karol-gruszczyk/arduino-racing-unit/README.md

# Racing Unit
Launch Control, Wheelie Control, QuickShifter
