karol-gruszczyk/arduino-racing-unit/schematic.pdf

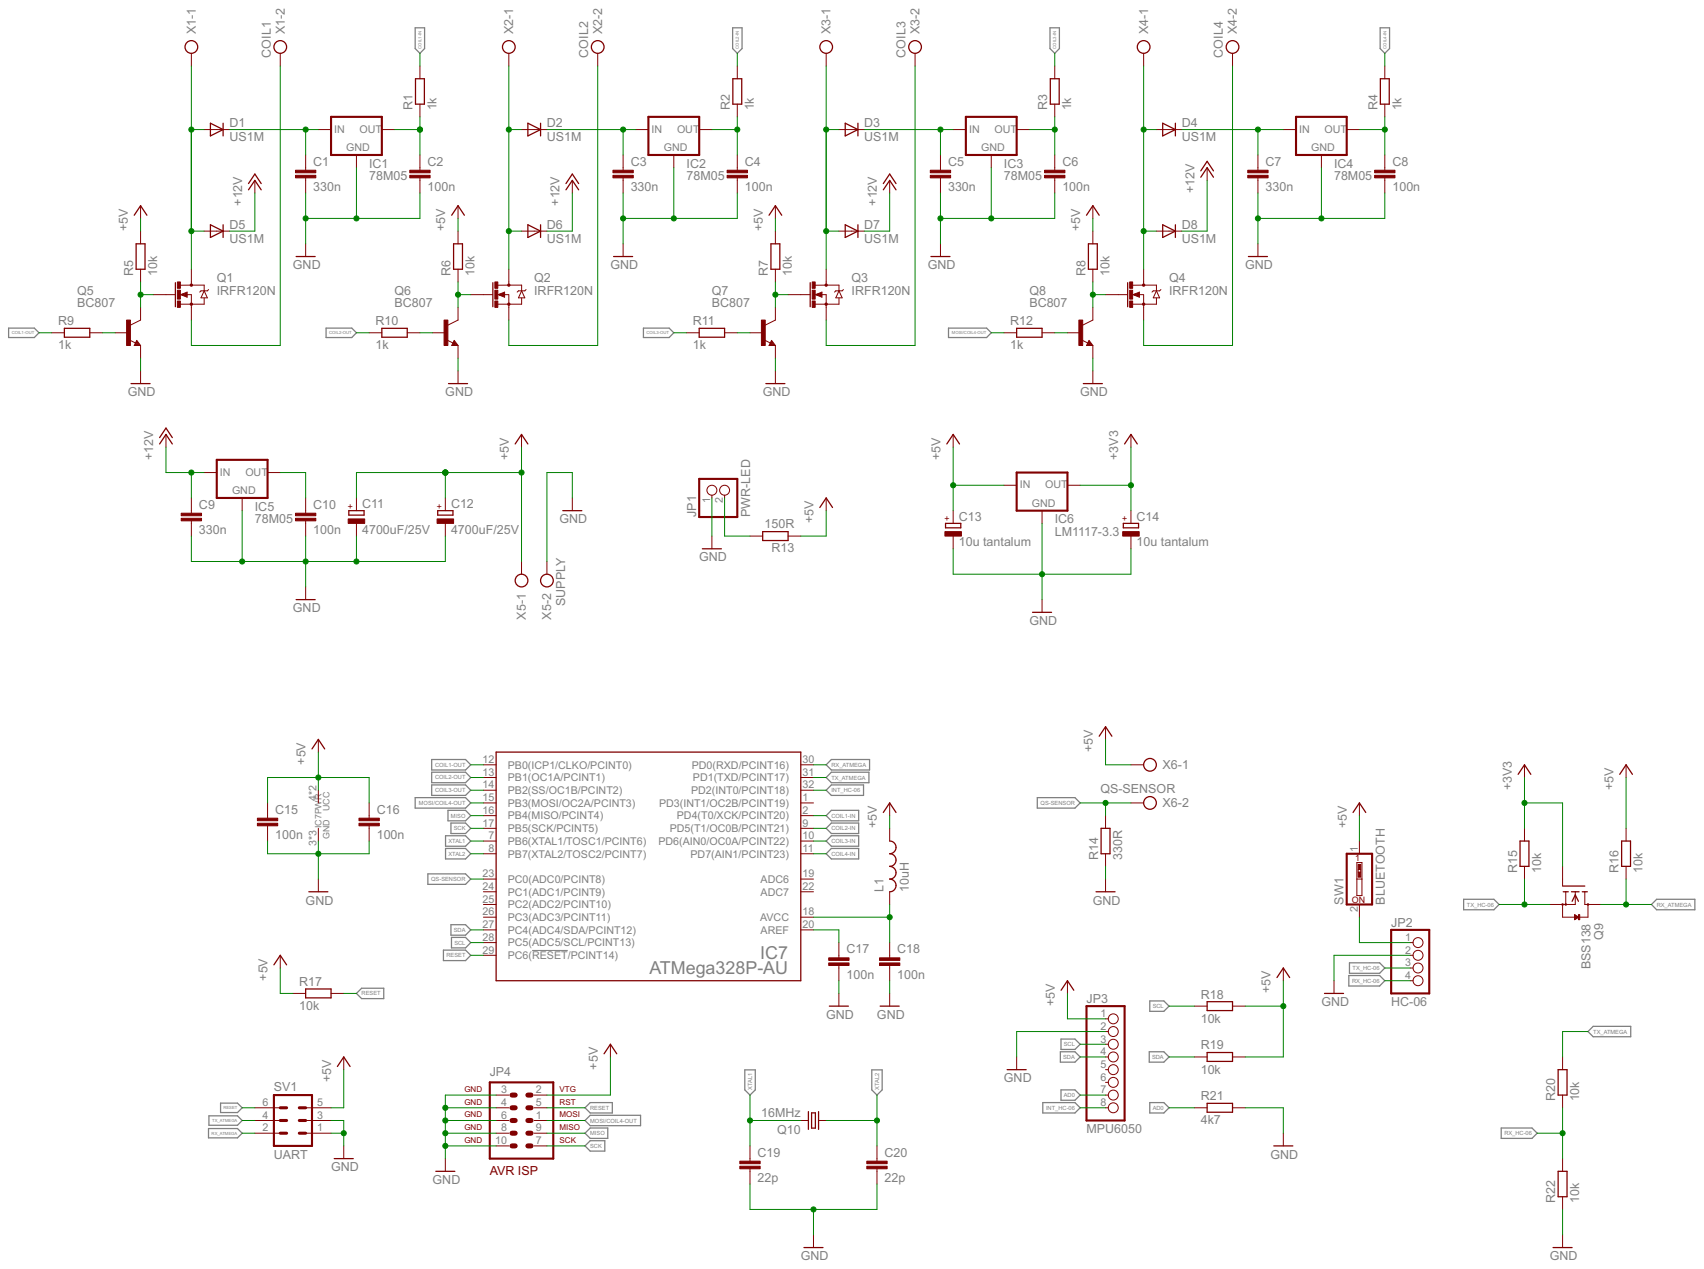
[picture p1: page 1]
