karol-gruszczyk/arduino-racing-unit/racing_unit.sch

## EAGLE design racing_unit.sch (2017-01-27)

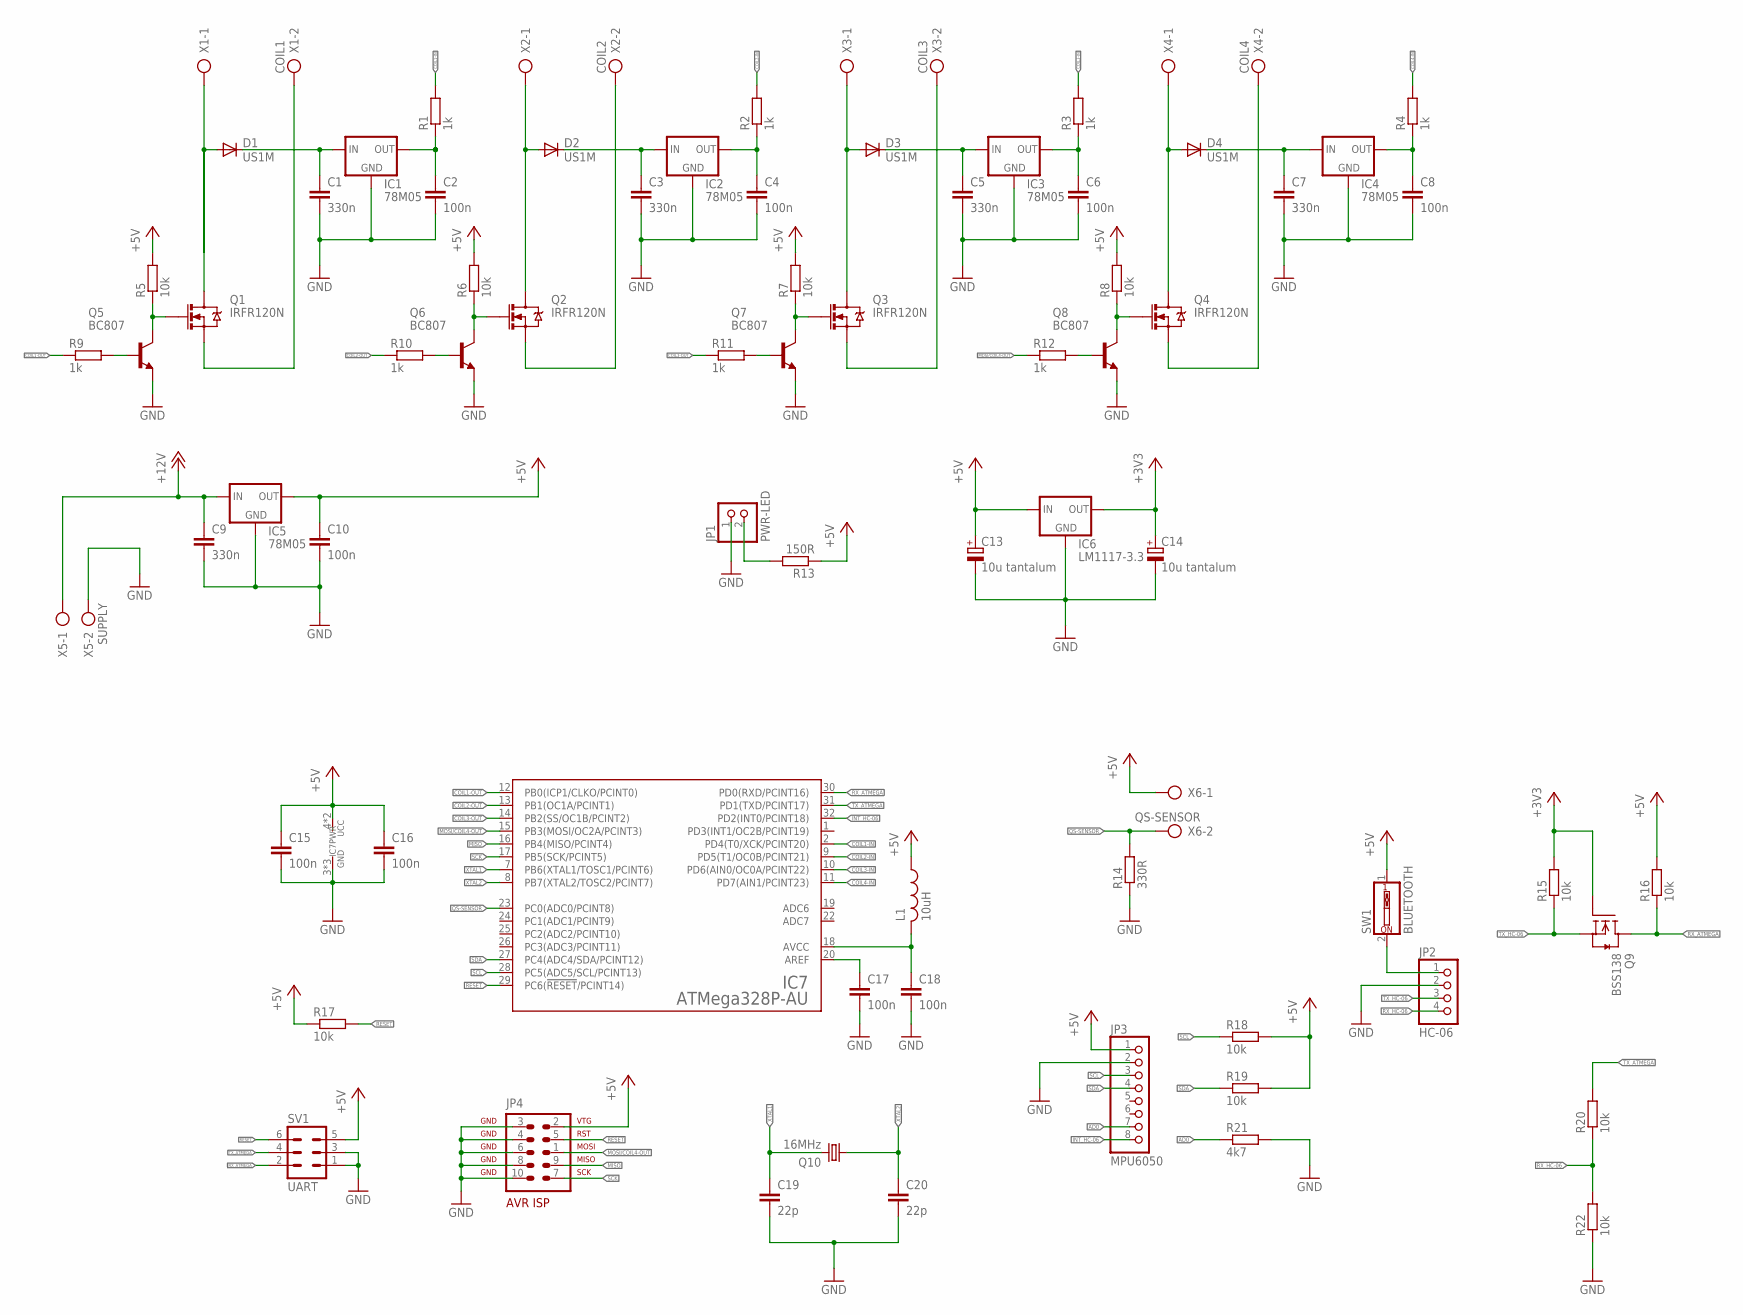
[picture p2: schematic racing_unit.sch]

Parts:
C1, C3, C5, C7, C9: 330n; C0805
C2, C4, C6, C8, C10, C15, C16, C17, C18: 100n; C0805
C13, C14: 10u tantalum; A/3216-18R
C19, C20: 22p; C0805
D1, D2, D3, D4: US1M; DO214AC
IC1, IC2, IC3, IC4, IC5: 78M05; TO252
IC6: LM1117-3.3; SOT223
IC7: ATMega328P-AU; TQFP32-08
JP1: PWR-LED; 1X02
JP2: HC-06; 1X04
JP3: MPU6050; 1X08
JP4: AVR-ISP-10ML; ML10
L1: 10uH; 0207/10
Q1, Q2, Q3, Q4: IRFR120N; D-PAK_TO252AA
Q5, Q6, Q7, Q8: BC807; SOT23-BEC
Q9: BSS138; SOT23
Q10: 16MHz; HC49/S
R1, R2, R3, R4, R9, R10, R11, R12: 1k; M0805
R5, R6, R7, R8, R15, R16, R17, R18, R19, R20, R22: 10k; M0805
R13: 150R; 0204/5
R14: 330R; 0204/5
R21: 4k7; M0805
SV1: UART; ML6
SW1: BLUETOOTH; EDG-01
X1: COIL1; AK500/2
X2: COIL2; AK500/2
X3: COIL3; AK500/2
X4: COIL4; AK500/2
X5: SUPPLY; AK500/2
X6: QS-SENSOR; AK500/2

Connections:
+3V3: C14.+, IC6.2 (OUT), Q9.1 (G), R15.2
+5V: C10.1, C13.+, C15.1, C16.1, IC5.3 (OUT), IC6.3 (IN), IC7.4 (UCC), JP3.1, JP4.2, L1.1, R5.2, R6.2, R7.2, R8.2, R13.1, R16.2, R17.1, R18.2, R19.2, SV1.5, SW1.1, X6.1
+12V: C9.1, IC5.2 (IN), X5.1
AD0: JP3.7, R21.1
COIL1-IN: IC7.2 (PD4(T0/XCK/PCINT20)), R1.2
COIL1-OUT: IC7.12 (PB0(ICP1/CLKO/PCINT0)), R9.1
COIL2-IN: IC7.9 (PD5(T1/OC0B/PCINT21)), R2.2
COIL2-OUT: IC7.13 (PB1(OC1A/PCINT1)), R10.1
COIL3-IN: IC7.10 (PD6(AIN0/OC0A/PCINT22)), R3.2
COIL3-OUT: IC7.14 (PB2(SS/OC1B/PCINT2)), R11.1
COIL4-IN: IC7.11 (PD7(AIN1/PCINT23)), R4.2
GND: C1.2, C2.2, C3.2, C4.2, C5.2, C6.2, C7.2, C8.2, C9.2, C10.2, C13.-, C14.-, C15.2, C16.2, C17.2, C18.2, C19.2, C20.2, IC1.1 (GND), IC2.1 (GND), IC3.1 (GND), IC4.1 (GND), IC5.1 (GND), IC6.1 (GND), IC7.3 (GND), JP1.1, JP2.2, JP3.2, JP4.3, JP4.4, JP4.6, JP4.8, JP4.10, Q5.E, Q6.E, Q7.E, Q8.E, R14.1, R21.2, R22.1, SV1.1, SV1.3, X5.2
INT_HC-06: IC7.32 (PD2(INT0/PCINT18)), JP3.8
MISO: IC7.16 (PB4(MISO/PCINT4)), JP4.9
MOSI/COIL4-OUT: IC7.15 (PB3(MOSI/OC2A/PCINT3)), JP4.1, R12.1
unnamed: D1.A, Q1.2 (D), X1.1
unnamed: D2.A, Q2.2 (D), X2.1
unnamed: D3.A, Q3.2 (D), X3.1
unnamed: D4.A, Q4.2 (D), X4.1
unnamed: C17.1, IC7.20 (AREF)
unnamed: C18.1, IC7.18 (AVCC), L1.2
unnamed: Q5.B, R9.2
unnamed: Q6.B, R10.2
unnamed: Q4.3 (S), X4.2
unnamed: Q3.3 (S), X3.2
unnamed: Q2.3 (S), X2.2
unnamed: Q1.3 (S), X1.2
unnamed: JP1.2, R13.2
unnamed: C2.1, IC1.3 (OUT), R1.1
unnamed: C4.1, IC2.3 (OUT), R2.1
unnamed: Q7.B, R11.2
unnamed: C8.1, IC4.3 (OUT), R4.1
unnamed: C6.1, IC3.3 (OUT), R3.1
unnamed: Q8.B, R12.2
unnamed: JP2.1, SW1.2
unnamed: C1.1, D1.C, IC1.2 (IN)
unnamed: C3.1, D2.C, IC2.2 (IN)
unnamed: C5.1, D3.C, IC3.2 (IN)
unnamed: C7.1, D4.C, IC4.2 (IN)
unnamed: Q1.1 (G), Q5.C, R5.1
unnamed: Q2.1 (G), Q6.C, R6.1
unnamed: Q3.1 (G), Q7.C, R7.1
unnamed: Q4.1 (G), Q8.C, R8.1
QS-SENSOR: IC7.23 (PC0(ADC0/PCINT8)), R14.2, X6.2
RESET: IC7.29 (PC6(!RESET!/PCINT14)), JP4.5, R17.2, SV1.6
RX_ATMEGA: IC7.30 (PD0(RXD/PCINT16)), Q9.3 (D), R16.1, SV1.2
RX_HC-06: JP2.4, R20.1, R22.2
SCK: IC7.17 (PB5(SCK/PCINT5)), JP4.7
SCL: IC7.28 (PC5(ADC5/SCL/PCINT13)), JP3.3, R18.1
SDA: IC7.27 (PC4(ADC4/SDA/PCINT12)), JP3.4, R19.1
TX_ATMEGA: IC7.31 (PD1(TXD/PCINT17)), R20.2, SV1.4
TX_HC-06: JP2.3, Q9.2 (S), R15.1
XTAL1: C19.1, IC7.7 (PB6(XTAL1/TOSC1/PCINT6)), Q10.2
XTAL2: C20.1, IC7.8 (PB7(XTAL2/TOSC2/PCINT7)), Q10.1
