karol-gruszczyk/arduino-racing-unit/racing_unit/setup_defaults/defaults.h

#define BLUETOOTH_NAME "Racing Unit"
#define BLUETOOTH_PIN "1234"
#define BLUETOOTH_BAUD_RATE "8"  // 115200
#define BLUETOOTH_BAUD_RATE_VERBOSE "115200"

#define CYLINDER_NUMBER 4

#define DEFAULT_LAUNCH_CONTROL_RPM 6000
#define DEFAULT_LAUNCH_CONTROL_KILL_TIME 100
#define DEFAULT_LAUNCH_CONTROL_WORKING_TIME 2000

#define DEFAULT_WHEELIE_CONTROL_ENABLED false
#define DEFAULT_WHEELIE_CONTROL_MAX_ANGLE 10
#define DEFAULT_WHEELIE_CONTROL_KILL_TIME 100

#define DEFAULT_QUICK_SHIFTER_ENABLED false
#define DEFAULT_QUICK_SHIFTER_MIN_RPM 2500
#define DEFAULT_QUICK_SHIFTER_MAX_RPM 14000
#define DEFAULT_QUICK_SHIFTER_SENSITIVITY 10
#define DEFAULT_QUICK_SHIFTER_KILL_TIME_AT_RPM {{2500, 80}, {4000, 80}, {5500, 75}, {7000, 75}, {8500, 70}, {10000, 70}, {11500, 65}, {13000, 65}}
#define QUICK_SHIFTER_KILL_TIME_ARRAY_SIZE 8
