karol-gruszczyk/arduino-racing-unit/racing_unit/globals.h

#ifndef GLOBALS_H_
#define GLOBALS_H_


struct globals_t
{
    uint16_t current_rpm = 0;
    bool rpm_rising = true;

    bool launch_control_enabled = false;
    int quick_shifter_sensor = 0;

    float ypr[3] = { 0.f, 0.f, 0.f };  // [yaw, pitch, roll]   yaw/pitch/roll container and gravity vector

    volatile bool spark_killed = false;
    unsigned long spark_restore_time = 0;
} globals;

#endif /* GLOBALS_H_ */
