karol-gruszczyk/arduino-racing-unit/(commit log)

2016-08-13 added schematic
    [racing_unit.sch]
2016-08-14 added interrupts for every cylinder and optymized types
2016-08-18 changed interrupts to change pin interrupts
2016-08-29 improved bt context and added spark cut-off test
2016-08-30 fixed lights switch and improved bt sockets
2016-08-30 added quickshifter sensor reading
2016-08-30 improved voltage divider calculation
2016-08-31 updated schematic
    [racing_unit.sch]
2016-08-31 fixed interrupts
2016-08-31 fixed initial pcint values
    [racing_unit.ino]
2016-09-05 added pcb design
    [racing_unit.brd, racing_unit.sch]
2016-09-05 fixed pcb
    [racing_unit.brd, racing_unit.sch]
2016-09-06 updated pcb and schematic
    [racing_unit.brd, racing_unit.sch]
2016-09-08 updated pcb and improved spark killing procedure
    [racing_unit.brd, racing_unit.sch]
2016-09-13 changed design to SMD
    [racing_unit.brd, racing_unit.sch]
2016-09-13 removed caption in schematic
2016-09-13 changed code to match arduino uno / atmega328p
    [racing_unit.sch]
2016-09-14 improved schematic
    [racing_unit.sch]
2016-09-14 changed coil switches to mosfet's
    [racing_unit.sch]
2016-09-15 added mosfet drivers and refactored launch control to be started by first spark kill
    [racing_unit.sch]
2016-09-18 improved rpm measurement
    [racing_unit.sch]
2016-09-20 fixed code warnings
    [racing_unit.sch]
2017-01-27 removed +12v supply from coils
    [racing_unit.sch]
